Ken-2511/low-noise-preamp/fabrication/low-noise-preamp-2026-11-07/ORDER-NOTES.txt

PCB fabrication: upload ../low-noise-preamp-2026-11-07.zip
2 layers; FR4; 73.5 x 34 mm (outline centerline); thickness 1.6 mm; outer copper 35 um (1 oz).
Assembly: hand soldering. No PCBA assembly, solder-paste stencil or component-placement files are included.
ZIP: 7 Gerber layers + separate PTH and NPTH Excellon drills + Gerber job file. The NPTH file is empty: all four M3 holes are plated.
ERC, DRC, unconnected, schematic parity checks: all 0; see checks/.
J1 and J2 are edge-mount SMA jacks; the board edge must stay at 1.6 mm thickness.
The GND ring around U1 is mask-free on purpose so a 20 x 15 mm shield can can be soldered on.
Parts: buy from low-noise-preamp-parts.csv (Source column says LCSC or Taobao); low-noise-preamp-bom.csv is the plain KiCad BOM.
The ZIP is generated from the current saved board; edits after export require regeneration.
