Ken-2511/low-noise-preamp/fabrication/low-noise-preamp-2026-11-07/checks/drill-report.txt

Drill report for low-noise-preamp.kicad_pcb
Created on 2026-11-07T21:35:02

Copper Layer Stackup:
    =============================================================
    L1 :  F.Cu                      front
    L2 :  B.Cu                      back

Drill file 'low-noise-preamp-PTH.drl' contains
    plated through holes:
    =============================================================
    T1  0.300mm  0.0118"  (41 holes))
    T2  0.800mm  0.0315"  (6 holes))
    T3  1.000mm  0.0394"  (22 holes))
    T4  1.200mm  0.0472"  (2 holes))
    T5  3.200mm  0.1260"  (4 holes))

    Total plated holes count 75

Drill file 'low-noise-preamp-NPTH.drl' contains
    unplated through holes:
    =============================================================

    Total unplated holes count 0
