Ken-2511/low-noise-preamp/fabrication/low-noise-preamp-2026-11-07/low-noise-preamp-parts.csv

Item | Qty on board | Buy | Source | Part to buy | LCSC part | Refs
ADA4898-1 | 1 | 2 | LCSC | ADA4898-1YRDZ (ADI) | C207988 | U1
OPA1612 | 1 | 2 | LCSC | OPA1612AIDR (TI) | C94590 | U2
680 uF 25 V electrolytic | 1 | 2 | Taobao | radial, 10-13 mm diameter, 5 mm lead pitch (搜 680uF 25V) |  | C1
330 uF 16 V electrolytic | 1 | 2 | LCSC | NXA 16V330 8*11.5 (SAMYOUNG), 8 mm, 3.5 mm pitch | C165541 | C2
220 uF 25 V electrolytic | 2 | 4 | LCSC | NXB25V220M8*11.5 3.5TP (SAMYOUNG), 8 mm, 3.5 mm pitch | C346947 | C6,C7
1 uF X7R 50 V 0805 | 1 | 10 | LCSC | CL21B105KBFNNNE (Samsung) | C28323 | C3
2.2 nF C0G 50 V 0603 | 1 | 50 | LCSC | 0603CG222J500NT (Fenghua) | C2991172 | C4
1 nF C0G 50 V 0603 | 1 | 50 | LCSC | CL10C102JB8NNNC (Samsung) | C163508 | C5
100 nF X7R 50 V 0603 | 4 | 100 | LCSC | CL10B104KB8NNNC (Samsung) | C1591 | C8,C9,C12,C13
10 uF X5R 25 V 0805 | 2 | 20 | LCSC | CL21A106KAYNNNE (Samsung) | C15850 | C10,C11
1N4148W | 2 | 10 | Taobao | 1N4148W SOD-123 |  | D1,D2
499 ohm 1% 0603 | 1 | 100 | LCSC | 0603WAF4990T5E (UNI-ROYAL) | C23065 | R1
10 ohm 1% 0603 | 1 | 100 | LCSC | 0603WAF100KT5E (UNI-ROYAL) | C22936 | R2
1 kohm 1% 0603 | 2 | 100 | LCSC | 0603WAF1001T5E (UNI-ROYAL) | C21190 | R3,R4
10 kohm 1% 0603 | 1 | 100 | LCSC | 0603WAF1002T5E (UNI-ROYAL) | C25804 | R5
1.1 kohm 1% 0603 | 1 | 100 | LCSC | 0603WAF1101T5E (UNI-ROYAL) | C22764 | R6
100 ohm 1% 0603 | 1 | 100 | LCSC | 0603WAF1000T5E (UNI-ROYAL) | C22775 | R7
15.8 kohm 1% 0603 | 1 | 100 | LCSC | 0603WAF1582T5E (UNI-ROYAL) | C22880 | R8
1.07 kohm 1% 0603 | 2 | 100 | LCSC | 0603WAF1071T5E (UNI-ROYAL) | C22762 | R9,R10
49.9 ohm 1% 0603 | 1 | 100 | LCSC | 0603WAF499JT5E (UNI-ROYAL) | C23185 | R11
47 ohm 1% 0805 | 2 | 100 | LCSC | 0805W8F470JT5E (UNI-ROYAL) | C17714 | R12,R13
SMA female edge-mount jack | 2 | 4 | Taobao | SMA-KE for 1.6 mm board; check leg spacing against the footprint |  | J1,J2
MSS-22D18 slide switch | 3 | 10 | LCSC | MSS-22D18G3 051 (SHOU HAN) | C7507430 | SW1,SW2,SW3
9 V battery snap, bare tinned leads 155 mm | 2 | 5 | LCSC | BE-13-018-155 (MYOUNG); solder leads straight into BT1/BT2 holes, red wire to the + hole marked on silk | C19184109 | BT1,BT2
Shield can 20 x 15 mm | 1 | 2 | Taobao | 屏蔽罩 20x15, tinplate, 3 mm or taller |  | over U1 ring
M3 nylon standoff + nut set | 4 | 1 set | Taobao | M3*25+6 尼龙柱 (25 mm clears the batteries underneath) |  | corner holes
SMA male to BNC male cable | 1 | 1 | Taobao | SMA公转BNC公 线 50 ohm |  | to scope
9 V battery | 2 | 2 | Taobao | 9V 电池 |  | off board
