Ken-2511/low-noise-preamp/fabrication/low-noise-preamp-2026-11-07/low-noise-preamp-bom.csv

Refs | Value | Footprint | Qty
BT1 | 9V upper | Connector_JST:JST_XH_B2B-XH-A_1x02_P2.50mm_Vertical | 1
BT2 | 9V lower | Connector_JST:JST_XH_B2B-XH-A_1x02_P2.50mm_Vertical | 1
C1 | 680uF 25V | Capacitor_THT:CP_Radial_D13.0mm_P5.00mm | 1
C2 | 330uF 16V | Capacitor_THT:CP_Radial_D8.0mm_P3.50mm | 1
C3 | 1uF X7R | Capacitor_SMD:C_0805_2012Metric_Pad1.18x1.45mm_HandSolder | 1
C4 | 2.2nF C0G | Capacitor_SMD:C_0603_1608Metric_Pad1.08x0.95mm_HandSolder | 1
C5 | 1nF C0G | Capacitor_SMD:C_0603_1608Metric_Pad1.08x0.95mm_HandSolder | 1
C6,C7 | 220uF 25V | Capacitor_THT:CP_Radial_D8.0mm_P3.50mm | 2
C8,C9,C12,C13 | 100nF | Capacitor_SMD:C_0603_1608Metric_Pad1.08x0.95mm_HandSolder | 4
C10,C11 | 10uF 25V | Capacitor_SMD:C_0805_2012Metric_Pad1.18x1.45mm_HandSolder | 2
D1,D2 | 1N4148W | Diode_SMD:D_SOD-123 | 2
J1 | SMA in | Connector_Coaxial:SMA_Samtec_SMA-J-P-H-ST-EM1_EdgeMount | 1
J2 | SMA out | Connector_Coaxial:SMA_Samtec_SMA-J-P-H-ST-EM1_EdgeMount | 1
R1 | 499 | Resistor_SMD:R_0603_1608Metric_Pad0.98x0.95mm_HandSolder | 1
R2 | 10 1% | Resistor_SMD:R_0603_1608Metric_Pad0.98x0.95mm_HandSolder | 1
R3 | 1k 1% | Resistor_SMD:R_0603_1608Metric_Pad0.98x0.95mm_HandSolder | 1
R4 | 1k | Resistor_SMD:R_0603_1608Metric_Pad0.98x0.95mm_HandSolder | 1
R5 | 10k 1% | Resistor_SMD:R_0603_1608Metric_Pad0.98x0.95mm_HandSolder | 1
R6 | 1.1k 1% | Resistor_SMD:R_0603_1608Metric_Pad0.98x0.95mm_HandSolder | 1
R7 | 100 1% | Resistor_SMD:R_0603_1608Metric_Pad0.98x0.95mm_HandSolder | 1
R8 | 15.8k 1% | Resistor_SMD:R_0603_1608Metric_Pad0.98x0.95mm_HandSolder | 1
R9,R10 | 1.07k 1% | Resistor_SMD:R_0603_1608Metric_Pad0.98x0.95mm_HandSolder | 2
R11 | 49.9 | Resistor_SMD:R_0603_1608Metric_Pad0.98x0.95mm_HandSolder | 1
R12,R13 | 47 | Resistor_SMD:R_0805_2012Metric_Pad1.20x1.40mm_HandSolder | 2
SW1 | 60 dB | low-noise-preamp:SW_Slide_DPDT_MSS-22D18 | 1
SW2 | POWER | low-noise-preamp:SW_Slide_DPDT_MSS-22D18 | 1
SW3 | 80 dB | low-noise-preamp:SW_Slide_DPDT_MSS-22D18 | 1
U1 | ADA4898-1 | Package_SO:SOIC-8-1EP_3.9x4.9mm_P1.27mm_EP2.29x3mm | 1
U2 | OPA1612 | Package_SO:SOIC-8_3.9x4.9mm_P1.27mm | 1
