Ken-2511/low-noise-preamp/low-noise-preamp.kicad_pcb

## KiCad design low-noise-preamp.kicad_pcb (2026-11-08)

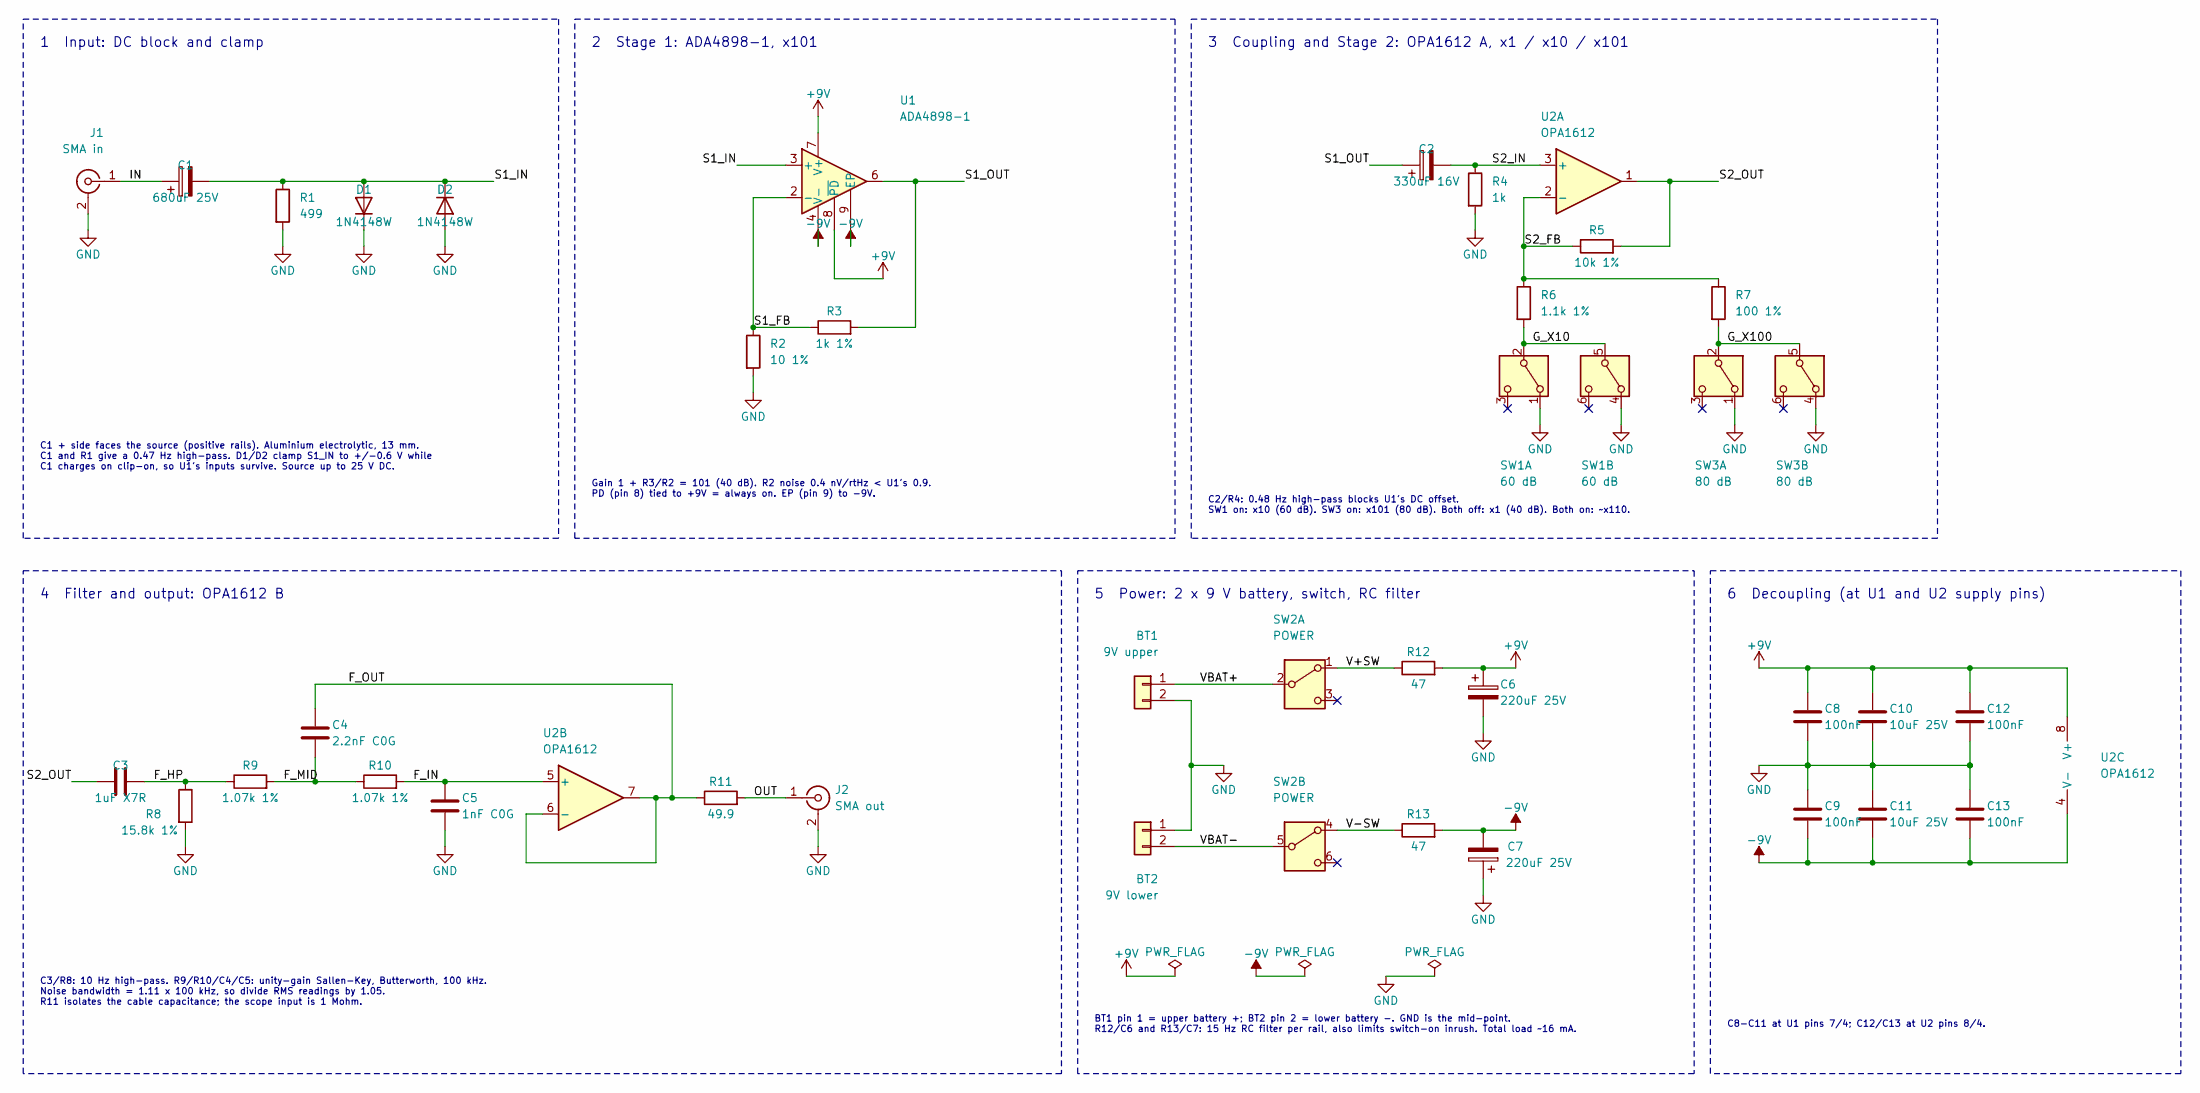
[picture p1: schematic low-noise-preamp.kicad_sch, uV noise preamplifier, 40/60/80 dB, 10 Hz - 100 kHz]

Parts:
BT1: 9V upper; JST_XH_B2B-XH-A_1x02_P2.50mm_Vertical
BT2: 9V lower; JST_XH_B2B-XH-A_1x02_P2.50mm_Vertical
C1: 680uF 25V; CP_Radial_D13.0mm_P5.00mm
C2: 330uF 16V; CP_Radial_D8.0mm_P3.50mm
C3: 1uF X7R; C_0805_2012Metric_Pad1.18x1.45mm_HandSolder
C4: 2.2nF C0G; C_0603_1608Metric_Pad1.08x0.95mm_HandSolder
C5: 1nF C0G; C_0603_1608Metric_Pad1.08x0.95mm_HandSolder
C6, C7: 220uF 25V; CP_Radial_D8.0mm_P3.50mm
C8, C9, C12, C13: 100nF; C_0603_1608Metric_Pad1.08x0.95mm_HandSolder
C10, C11: 10uF 25V; C_0805_2012Metric_Pad1.18x1.45mm_HandSolder
D1, D2: 1N4148W; D_SOD-123
J1: SMA in; SMA_Samtec_SMA-J-P-H-ST-EM1_EdgeMount
J2: SMA out; SMA_Samtec_SMA-J-P-H-ST-EM1_EdgeMount
R1: 499; R_0603_1608Metric_Pad0.98x0.95mm_HandSolder
R2: 10 1%; R_0603_1608Metric_Pad0.98x0.95mm_HandSolder
R3: 1k 1%; R_0603_1608Metric_Pad0.98x0.95mm_HandSolder
R4: 1k; R_0603_1608Metric_Pad0.98x0.95mm_HandSolder
R5: 10k 1%; R_0603_1608Metric_Pad0.98x0.95mm_HandSolder
R6: 1.1k 1%; R_0603_1608Metric_Pad0.98x0.95mm_HandSolder
R7: 100 1%; R_0603_1608Metric_Pad0.98x0.95mm_HandSolder
R8: 15.8k 1%; R_0603_1608Metric_Pad0.98x0.95mm_HandSolder
R9, R10: 1.07k 1%; R_0603_1608Metric_Pad0.98x0.95mm_HandSolder
R11: 49.9; R_0603_1608Metric_Pad0.98x0.95mm_HandSolder
R12, R13: 47; R_0805_2012Metric_Pad1.20x1.40mm_HandSolder
SW1: 60 dB; SW_Slide_DPDT_MSS-22D18
SW2: POWER; SW_Slide_DPDT_MSS-22D18
SW3: 80 dB; SW_Slide_DPDT_MSS-22D18
U1: ADA4898-1; SOIC-8-1EP_3.9x4.9mm_P1.27mm_EP2.29x3mm
U2: OPA1612; SOIC-8_3.9x4.9mm_P1.27mm

Connections:
+9V: C6.1, C8.1, C10.1, C12.1, R12.2, U1.7 (V+), U1.8 (~PD), U2.8 (V+)
-9V: C7.2, C9.2, C11.2, C13.2, R13.2, U1.4 (V-), U1.9 (EP), U2.4 (V-)
/F_HP: C3.2, R8.1, R9.1
/F_IN: C5.1, R10.2, U2.5 (+)
/F_MID: C4.2, R9.2, R10.1
/F_OUT: C4.1, R11.1, U2.6 (-), U2.7
/G_X10: R6.2, SW1.2 (B), SW1.5 (B)
/G_X100: R7.2, SW3.2 (B), SW3.5 (B)
/IN: C1.1, J1.1 (In)
/OUT: J2.1 (In), R11.2
/S1_FB: R2.1, R3.1, U1.2 (-)
/S1_IN: C1.2, D1.2 (A), D2.1 (K), R1.1, U1.3 (+)
/S1_OUT: C2.1, R3.2, U1.6
/S2_FB: R5.1, R6.1, R7.1, U2.2 (-)
/S2_IN: C2.2, R4.1, U2.3 (+)
/S2_OUT: C3.1, R5.2, U2.1
/V+SW: R12.1, SW2.1 (A)
/V-SW: R13.1, SW2.4 (A)
/VBAT+: BT1.1, SW2.2 (B)
/VBAT-: BT2.2, SW2.5 (B)
GND: BT1.2, BT2.1, C5.2, C6.2, C7.1, C8.2, C9.1, C10.2, C11.1, C12.2, C13.1, D1.1 (K), D2.2 (A), J1.2 (Ext), J2.2 (Ext), R1.2, R2.2, R4.2, R8.2, SW1.1 (A), SW1.4 (A), SW3.1 (A), SW3.4 (A); also elsewhere on the board

Notes on the sheet:
1 Input: DC block and clamp
C1 + side faces the source (positive rails). Aluminium electrolytic, 13 mm. C1 and R1 give a 0.47 Hz high-pass. D1/D2 clamp S1_IN to +/-0.6 V while C1 charges on clip-on, so U1's inputs survive. Source up to 25 V DC.
2 Stage 1: ADA4898-1, x101
Gain 1 + R3/R2 = 101 (40 dB). R2 noise 0.4 nV/rtHz < U1's 0.9. PD (pin 8) tied to +9V = always on. EP (pin 9) to -9V.
3 Coupling and Stage 2: OPA1612 A, x1 / x10 / x101
C2/R4: 0.48 Hz high-pass blocks U1's DC offset. SW1 on: x10 (60 dB). SW3 on: x101 (80 dB). Both off: x1 (40 dB). Both on: ~x110.
4 Filter and output: OPA1612 B
C3/R8: 10 Hz high-pass. R9/R10/C4/C5: unity-gain Sallen-Key, Butterworth, 100 kHz. Noise bandwidth = 1.11 x 100 kHz, so divide RMS readings by 1.05. R11 isolates the cable capacitance; the scope input is 1 Mohm.
5 Power: 2 x 9 V battery, switch, RC filter
BT1 pin 1 = upper battery +; BT2 pin 2 = lower battery -. GND is the mid-point. R12/C6 and R13/C7: 15 Hz RC filter per rail, also limits switch-on inrush. Total load ~16 mA.
6 Decoupling (at U1 and U2 supply pins)
C8-C11 at U1 pins 7/4; C12/C13 at U2 pins 8/4.

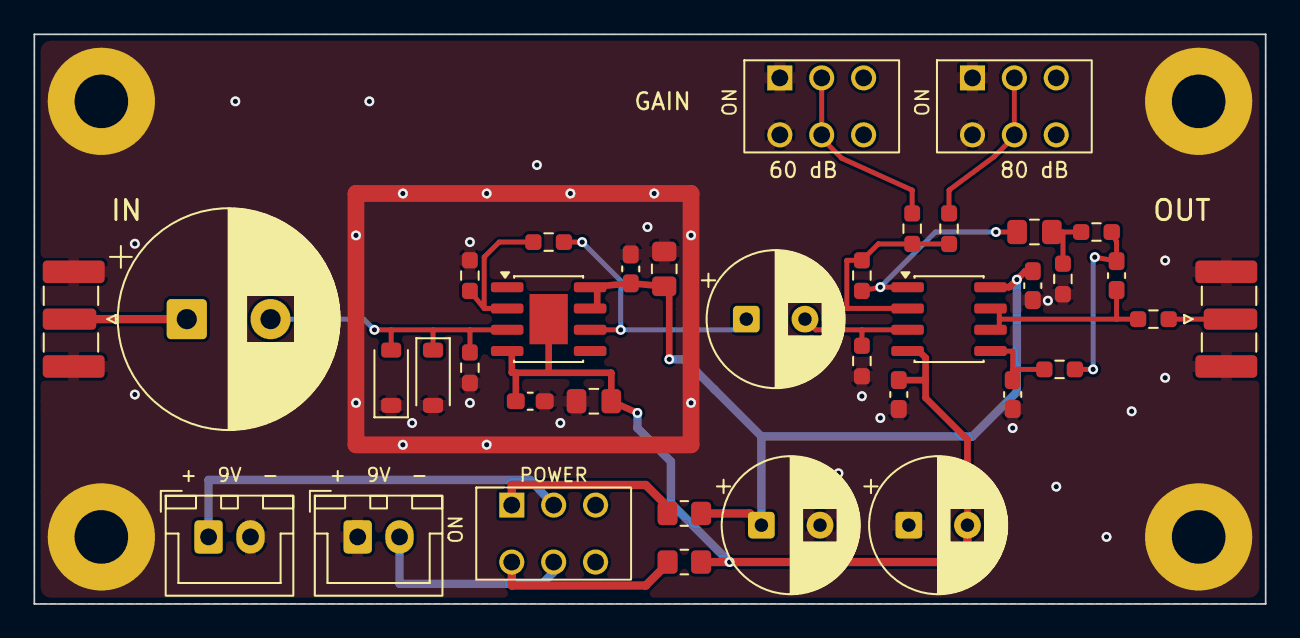
[picture p2: board low-noise-preamp.kicad_pcb from above]

Board: 2 copper layers, 73.5 x 34.0 mm, 41 parts (0 on the bottom side), 21 nets.

Other parts of the board:
H1, H2, H3, H4: M3; MountingHole_3.2mm_M3_Pad

Their connections:
GND: H1.1, H2.1, H3.1, H4.1; also elsewhere on the board
