Ken-2511/low-noise-preamp/fabrication/low-noise-preamp-2026-11-07/checks/pcb-top.png

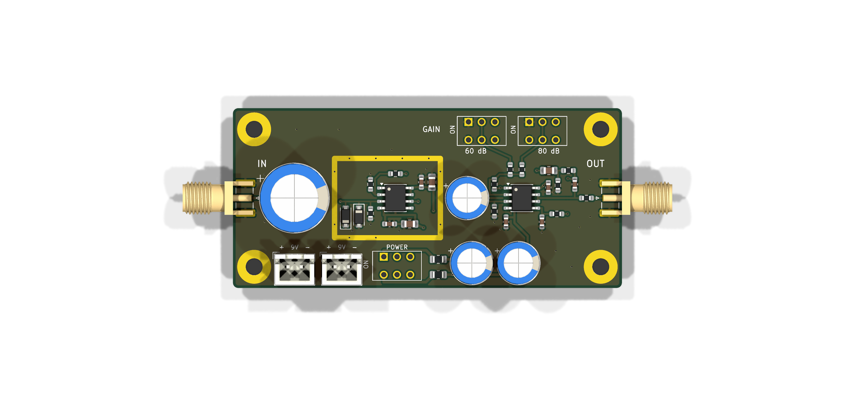
fabrication/low-noise-preamp-2026-11-07/checks/pcb-top.png
