Ken-2511/low-noise-preamp/(commit log)

2026-11-01 Draw the preamp schematic
    ADA4898-1 x101 stage, OPA1612 x1/x10/x101 switched stage, 10 Hz high-pass and 100 kHz Sallen-Key low-pass, SMA in and out, +/-9 V from two 9 V batteries. ERC: 0 violations.
    [low-noise-preamp.kicad_pcb, low-noise-preamp.kicad_sch]
2026-11-07 Lay out and route the preamp PCB
    Compact 73.5 x 34 mm two-layer board with both SMA ports on the centre line,
    an optional 20 x 15 mm shield-can ring over the input and stage 1, MSS-22D18
    slide switches for gain and power, and 47 ohm rail resistors.
    [low-noise-preamp.kicad_pcb, low-noise-preamp.kicad_sch]
2026-11-07 Archive PCB fabrication package and Taobao parts list
    [low-noise-preamp-B_Cu.gbl, low-noise-preamp-B_Mask.gbs, low-noise-preamp-B_Silkscreen.gbo, low-noise-preamp-Edge_Cuts.gm1, low-noise-preamp-F_Cu.gtl, low-noise-preamp-F_Mask.gts, low-noise-preamp-F_Silkscreen.gto, low-noise-preamp-NPTH.drl]
2026-11-08 Split the parts list between LCSC and Taobao
    [low-noise-preamp-parts.csv, low-noise-preamp-taobao.csv]
2026-11-08 Buy 9 V snaps from LCSC and use 25 mm standoffs
    Taobao blocks battery snaps, so BT1/BT2 now take LCSC bare-lead snaps (C19184109) soldered into the board holes, and the XH headers are dropped. The standoffs are 25 mm so the batteries fit under the board.
    [low-noise-preamp-parts.csv]
2026-11-08 Fix slide switch pin-row spacing to 3.4 mm
    The SHOU HAN MSS-22D18 datasheet puts the two pin rows 3.4 mm apart, not 2.9 mm. SW2 moves up 0.5 mm and the VBAT+ trace moves 0.6 mm up to keep clearance. Gerbers, drill files, checks and the zip are regenerated; DRC, ERC and parity are all 0.
    [low-noise-preamp-B_Cu.gbl, low-noise-preamp-B_Mask.gbs, low-noise-preamp-B_Silkscreen.gbo, low-noise-preamp-Edge_Cuts.gm1, low-noise-preamp-F_Cu.gtl, low-noise-preamp-F_Mask.gts, low-noise-preamp-F_Silkscreen.gto, low-noise-preamp-NPTH.drl]
